airsoftak25/Bobutek-LineFollower/README.md

# Team
- Vadim Sobčuk - Modeling / Elektro
- Daniel Pelikán - Code / Elektro
- Luboš Stránský - PCB Manufacture
# Description
We are czech students from High school - prumyslova skola prosek - that enjoy making robots in the free time,
