airsoftak25/Bobutek-LineFollower/PCB/README.md

PCB for the line follower will be here
reffered to as MK and a number ascending from 1 to idk where will be the end but you get the gist of it
there will also be a folder for .lib stuff for kicad if you will be interested 
this may get updated or changed but i will try to keep it readable
