airsoftak25/Bobutek-LineFollower/PCB/MK I/README.md

# About
This Folder Holds DWG file (edge cuts), exel files with components, gerber files (Main and Senzor) and Kicad Projects of LF-Zetro MKI 

Maded by Bobutek team with help from Otto von Bismax :D
