airsoftak25/Bobutek-LineFollower/PCB/MK II/README.md

# About
This folder will hold Kicad Projects and gerber files of MKII fl-Untilted

It will be maded by Bobutek Team with help from Otto von bismax :D
