airsoftak25/Bobutek-LineFollower/PCB/MK I/FL-Zetor Součástky.xlsx

Name | Footprint | Link / Datasheet | Ammount
TB6612FNG | TB6612FNG | TB6612FNG - Laskakit (https://www.laskakit.cz/user/related_files/tb6612fng_datasheet_en_20141001.pdf) | 5
MCU | ESP WROOM 32 |  | 1
Motor | Polulu | 30:1 motor HPCB 12V with 12 CPR Encoder - Polulu (https://www.pololu.com/product/5211/resources) | 2
MP1584 - Stepdown |  | StepDown - GME (https://www.gme.cz/v/1508976/modul-nastavitelneho-zdroje-step-down-25-20v-1a2a) | 1
LM1086 | TO-220 | LM1086 Stab. 5v - Mouser (https://cz.mouser.com/ProductDetail/Texas-Instruments/LM1086CT-ADJ-NOPB?qs=X1J7HmVL2ZG9qiSfzMA5kQ%3D%3D) | 1
