airsoftak25/Bobutek-LineFollower/Models/ProtorV1.0-Zelva/kryt2.STL

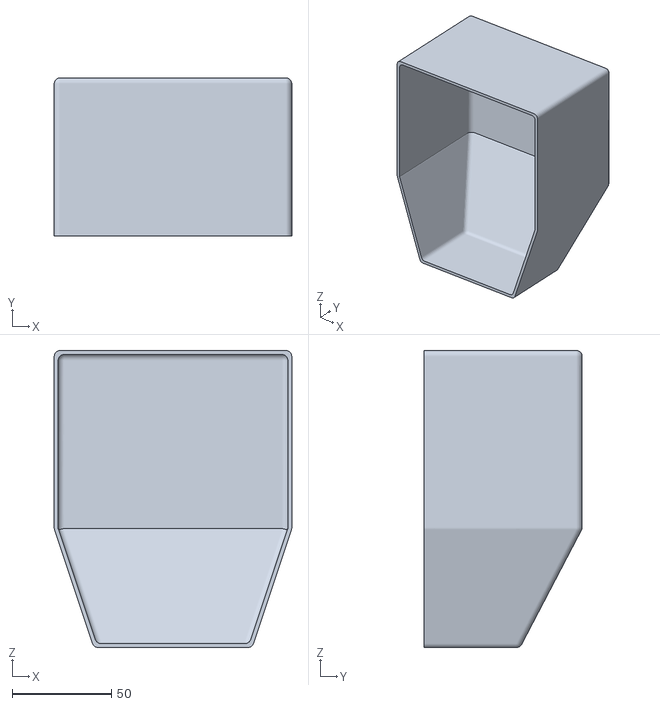
[picture p1: CAD file, 2025-04-15]
Models/ProtorV1.0-Zelva/kryt2.STL
120.0 x 80.0 x 150.0
