airsoftak25/Bobutek-LineFollower/PCB/MK I/Fl-Zetor.dxf

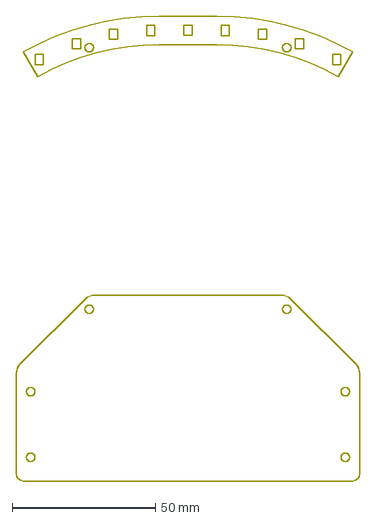
[picture p2: CAD file, 2025-05-07]
PCB/MK I/Fl-Zetor.dxf
120.0 x 162.5 mm
