airsoftak25/Bobutek-LineFollower/Models/ProtorV1.0-Zelva/robot2.STL

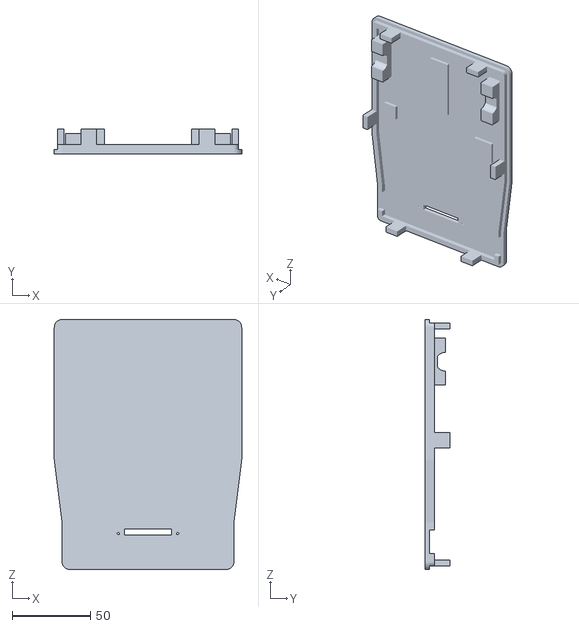
[picture p3: CAD file, 2025-04-15]
Models/ProtorV1.0-Zelva/robot2.STL
120.0 x 16.0 x 160.0
