airsoftak25/Bobutek-LineFollower/(list of files, cad)

Other CAD files:
PCB/MK I/FL-Zetor/Fl-Zetor - cut.dwg
Models/MK I/Držak motoru.ipt
PCB/MK I/Fl-Zetor.dwg
