airsoftak25/Bobutek-LineFollower/PCB/MK I/FL-Zetor/FL-Zetor.kicad_pcb

## KiCad design PCB/MK I/FL-Zetor/FL-Zetor.kicad_pcb (2025-05-14)

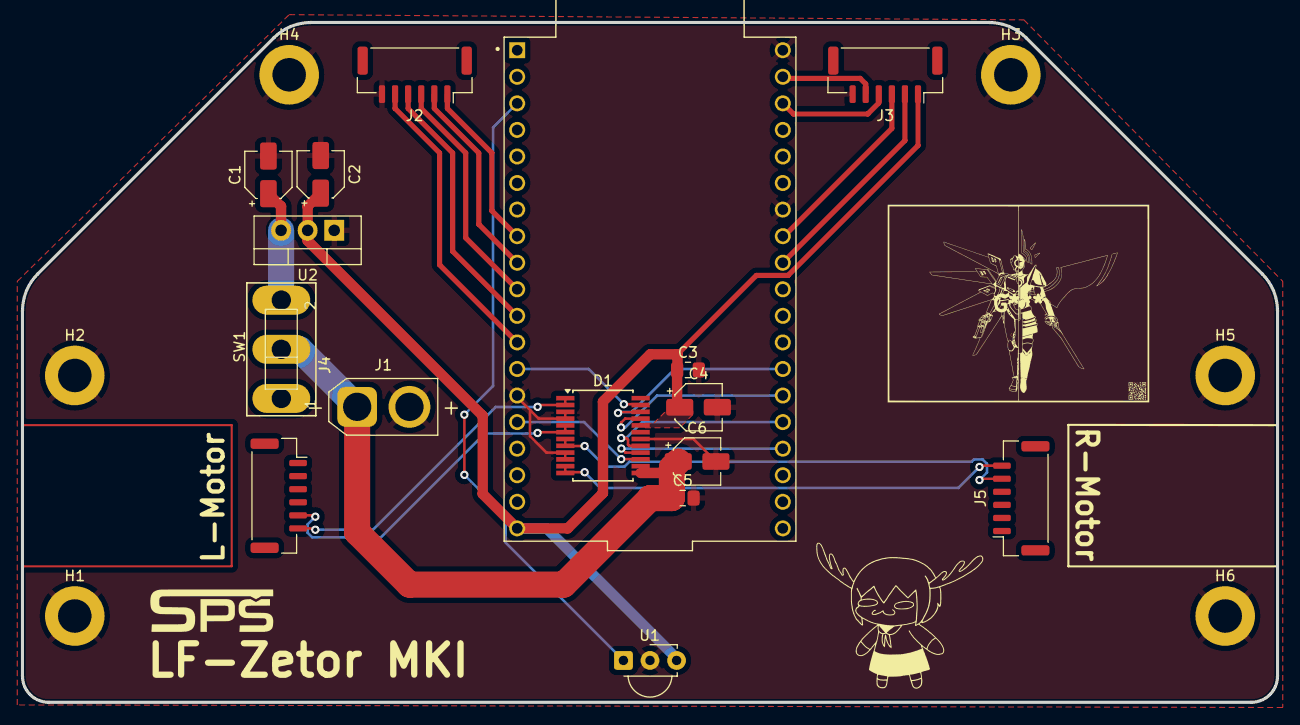
[picture p4: board FL-Zetor.kicad_pcb from above]

Board: 2 copper layers, 120.0 x 65.0 mm, 22 parts (0 on the bottom side), 23 nets.

Parts:
C1, C2, C4, C6: 10uF; CP_Elec_4x5.4
C3, C5: 100nF; C_0805_2012Metric_Pad1.18x1.45mm_HandSolder
D1: TB6612FNG; SSOP-24_5.3x8.2mm_P0.65mm
H1, H2, H3, H4, H5, H6: MountingHole_Pad; MountingHole_3.2mm_M3_ISO7380_Pad
J1: Conn_01x02_Pin; AMASS_XT30U-F_1x02_P5.0mm_Vertical
J2, J3, J4, J5: Conn_01x06_Pin; JST_GH_SM06B-GHS-TB_1x06-1MP_P1.25mm_Horizontal
MCU1: DEVKIT_V1_ESP32-WROOM-32; MODULE_DEVKIT_V1_ESP32-WROOM-32
SW1: SL19; 255SB
U1: TSOP382xx; Vishay_MINICAST-3Pin
U2: LM1086; TO-220-3_Vertical

Connections:
+5V: C2.1, C3.1, C4.1, D1.20 (VCC), J3.1, MCU1.19 (EXT_5V), U1.3 (Vs), U2.2 (VO)
+12V: C1.1, C5.1, C6.1, D1.13 (VM2), D1.14 (VM3), D1.24 (VM1), J1.1, SW1.2 (B), SW1.3 (C), U2.3 (VI)
D-pin-ESP: MCU1.3 (SENSOR_VP), U1.1 (OUT)
D.M.C.A.1: D1.21 (AIN1), MCU1.25 (IO0)
D.M.C.A.2: D1.22 (AIN2), MCU1.26 (IO4)
D.M.C.B.1: D1.17 (BIN1), MCU1.24 (IO2)
D.M.C.B.2: D1.16 (BIN2), MCU1.23 (IO15)
GND: C1.2, C2.2, C3.2, C4.2, C5.2, C6.2, D1.3 (PGND1), D1.4 (PGND1), D1.9 (PGND2), D1.10 (PGND2), D1.18 (GND), H1.1, H2.1, H3.1, H4.1, H5.1, H6.1, J1.2, J2.6, J3.6, MCU1.14 (GND1), MCU1.32 (GND2), MCU1.38 (GND3), U1.2 (GND), U2.1 (ADJ)
LM1: D1.1 (AO1), D1.2 (AO1), J4.6
LM2: D1.5 (AO2), D1.6 (AO2), J4.5
PWM_A: D1.23 (PWMA), MCU1.13 (IO12)
PWM_B: D1.15 (PWMB), MCU1.15 (IO13)
RM1: D1.11 (BO1), D1.12 (BO1), J5.6
RM2: D1.7 (BO2), D1.8 (BO2), J5.5
S_D1: J2.5, MCU1.12 (IO14)
S_D2: J2.4, MCU1.11 (IO27)
S_D3: J2.3, MCU1.10 (IO26)
S_D4: J2.2, MCU1.9 (IO25)
S_D5: J2.1, MCU1.8 (IO33)
S_D6: J3.5, MCU1.37 (IO23)
S_D7: J3.4, MCU1.36 (IO22)
S_D8: J3.3, MCU1.31 (IO19)
S_D9: J3.2, MCU1.30 (IO18)
