airsoftak25/Bobutek-LineFollower/PCB/MK I/FL-Zetor/FL-Zetor-Senzor/FL-Zetor-Senzor.kicad_pcb

## KiCad design PCB/MK I/FL-Zetor/FL-Zetor-Senzor/FL-Zetor-Senzor.kicad_pcb (2025-05-09)

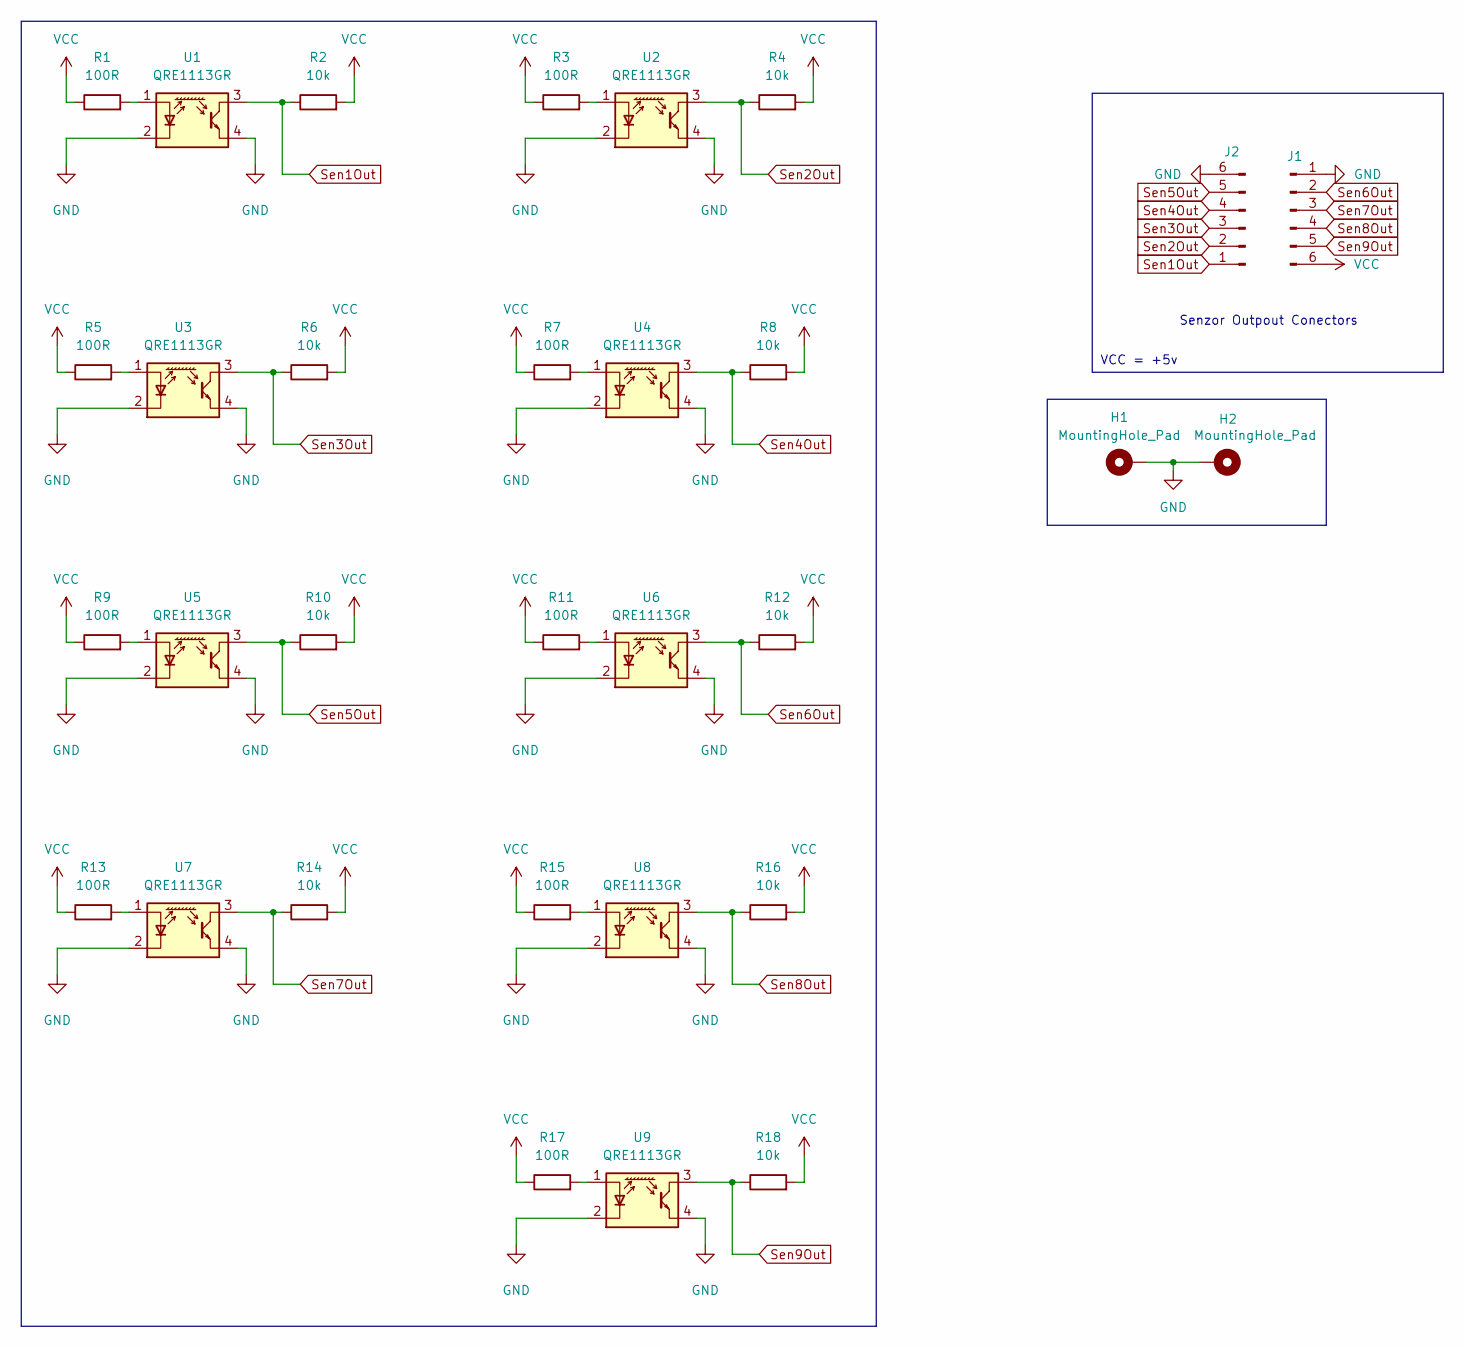
[picture p5: schematic FL-Zetor-Senzor.kicad_sch]

Parts:
H1, H2: MountingHole_Pad; MountingHole_3.2mm_M3_ISO7380_Pad
J1, J2: Conn_01x06_Pin; JST_GH_SM06B-GHS-TB_1x06-1MP_P1.25mm_Horizontal
R1, R3, R5, R7, R9, R11, R13, R15, R17: 100R; R_0805_2012Metric; LCSC C17408
R2, R4, R6, R8, R10, R12, R14, R16, R18: 10k; R_0805_2012Metric; LCSC C17414
U1, U2, U3, U4, U5, U6, U7, U8, U9: QRE1113GR; OnSemi_CASE100CY; LCSC C232862

Connections:
GND: H1.1, H2.1, J1.1, J2.6, U1.2 (K), U1.4, U2.2 (K), U2.4, U3.2 (K), U3.4, U4.2 (K), U4.4, U5.2 (K), U5.4, U6.2 (K), U6.4, U7.2 (K), U7.4, U8.2 (K), U8.4, U9.2 (K), U9.4
unnamed: R1.2, U1.1 (A)
unnamed: R3.2, U2.1 (A)
unnamed: R5.2, U3.1 (A)
unnamed: R7.2, U4.1 (A)
unnamed: R9.2, U5.1 (A)
unnamed: R11.2, U6.1 (A)
unnamed: R13.2, U7.1 (A)
unnamed: R15.2, U8.1 (A)
unnamed: R17.2, U9.1 (A)
Sen1Out: J2.1, R2.1, U1.3
Sen2Out: J2.2, R4.1, U2.3
Sen3Out: J2.3, R6.1, U3.3
Sen4Out: J2.4, R8.1, U4.3
Sen5Out: J2.5, R10.1, U5.3
Sen6Out: J1.2, R12.1, U6.3
Sen7Out: J1.3, R14.1, U7.3
Sen8Out: J1.4, R16.1, U8.3
Sen9Out: J1.5, R18.1, U9.3
VCC: J1.6, R1.1, R2.2, R3.1, R4.2, R5.1, R6.2, R7.1, R8.2, R9.1, R10.2, R11.1, R12.2, R13.1, R14.2, R15.1, R16.2, R17.1, R18.2

Notes on the sheet:
Senzor Outpout Conectors
VCC = +5v

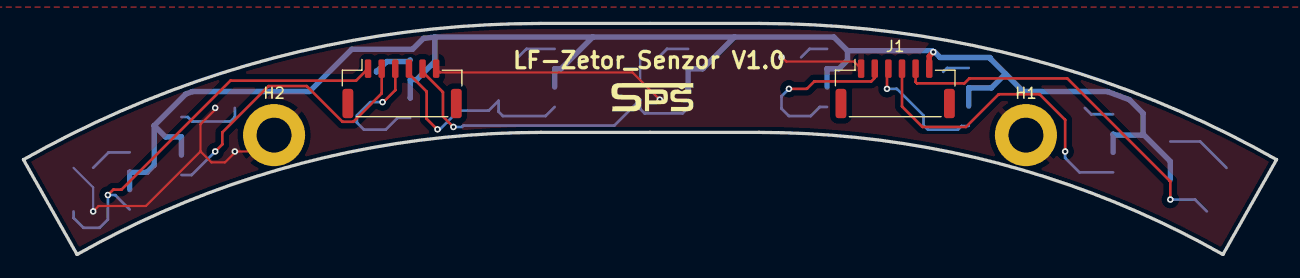
[picture p6: board FL-Zetor-Senzor.kicad_pcb from above]

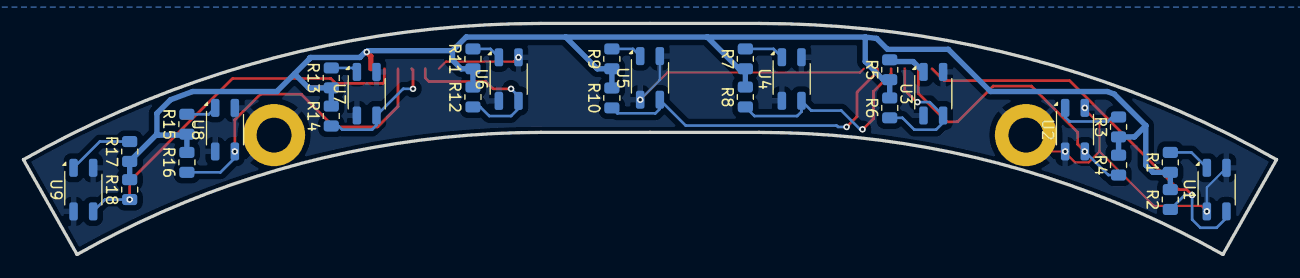
[picture p7: board FL-Zetor-Senzor.kicad_pcb from below]

Board: 2 copper layers, 115.0 x 21.2 mm, 31 parts (27 on the bottom side), 20 nets.
