airsoftak25/Bobutek-LineFollower/(commit log)

2025-04-22 Update about prototype
2025-04-28 Update About
    about for pcbs
2025-04-28 Create Z{zelva} PCB settup
    someone post the autocad there
2025-04-28 Create Fl-Zetor - cut.dwg
    [Fl-Zetor - cut.dwg]
2025-04-29 dxf import
    dwg do kicadu nefuguje potrenu dxf
    [Fl-Zetor - cut.dxf]
2025-04-29 savva mi bije
    au
    [Fl-Zetor - cut.dwg, TB315A56612FNG_TO_THT.kicad_pcb, TB315A56612FNG_TO_THT.kicad_sch]
2025-04-29 Upload Držák motoru
    [Držak motoru.ipt]
2025-04-29 Upload new Main Edge Cut and other things
    [FL-Zetor Součástky.xlsx, Fl-Zetor - Main edge cut.dxf, Fl-Zetor - cut.dwg, Fl-Zetor - cut.dxf, Fl-Zetor - edge cut.dwg]
2025-04-29 ki cad bs
    bs
    [TB315A56612FNG_TO_THT.kicad_pcb]
2025-04-29 ki cad
    things
    [TB315A56612FNG_TO_THT.kicad_pcb, TB315A56612FNG_TO_THT.kicad_sch]
2025-04-29 ki cad
    savva mi bnarval do prdele curaka
    [TB315A56612FNG_TO_THT.kicad_pcb, TB315A56612FNG_TO_THT.kicad_sch]
2025-04-30 redesighn edge cuts
    [Fl-Zetor - Main edge cut.dxf, Fl-Zetor - edge cut.dwg, Fl-Zetor.dwg]
2025-05-06 pluh
    mk update
    [TB315A56612FNG_TO_THT.kicad_sch, senzor_ring.kicad_pcb, senzor_ring.kicad_sch]
2025-05-06 ehhh
    eeeeh
    [TB315A56612FNG_TO_THT.kicad_sch, senzor_ring.kicad_sch, untitled.kicad_sch]
2025-05-06 saveee
    s
    [senzor_ring.kicad_sch, untitled.kicad_sch]
2025-05-07 Patch some shits
    Potřeby jemně předělat senzor
    [Fl-Zetor.dwg, Fl-Zetor.dxf, TB315A56612FNG_TO_THT.kicad_pcb, senzor_ring.kicad_sch, untitled.kicad_sch]
2025-05-08 pcb shit
    [TB315A56612FNG_TO_THT.kicad_pcb, senzor_ring.kicad_sch, untitled.kicad_sch]
2025-05-08 rename pcb files
    [FL-Zetor.kicad_pcb, FL-Zetor.kicad_sch, Fl-Zetor - cut.dwg, senzor_ring.kicad_sch, untitled.kicad_sch]
2025-05-09 pcbs done
    that pieces of craps is done
    [FL-Zetor-Senzor.kicad_pcb, FL-Zetor-Senzor.kicad_sch, FL-Zetor.kicad_pcb, FL-Zetor.kicad_sch, untitled.kicad_sch]
2025-05-09 update for senzot + grb files
    [FL-Zetor-B_Cu.gbr, FL-Zetor-B_Mask.gbr, FL-Zetor-B_Paste.gbr, FL-Zetor-B_Silkscreen.gbr, FL-Zetor-Edge_Cuts.gbr, FL-Zetor-F_Cu.gbr, FL-Zetor-F_Mask.gbr, FL-Zetor-F_Paste.gbr]
2025-05-15 some shit
    [FL-Zetor.kicad_pcb, untitled.kicad_sch]
